HankYu11/3D-printer/docs/04-dfm-and-print-spec.md

# 04 — DFM and Print Specification

## The orientation decision

**Print the part lying on a cheek. Build direction is the part's lateral (Y)
axis.** Everything else in the DFM follows from this, and it is worth the space
because it is the single highest-leverage decision in the design.

### Why not upright

Printed upright — shoe flat on the bed, grip rising — the layer planes are
horizontal. The neck's bending stress and the dovetail wall's splay stress both
run vertically, which means they run **normal to every layer bond**. PETG's
interlayer strength is roughly 27 MPa against about 47 MPa in-plane, so upright
printing throws away ~43 % of the material's strength in exactly the direction
the part is loaded. The grip would also need support under the raked stem.

### Why on a cheek

Lying on a cheek, the layer planes are the part's XZ planes. Now:

- The neck's bending stress lies **inside** the layer plane, carried by
  continuous extrusions rather than by bonds between them.
- The dovetail wall's splay stress likewise runs along Z, in-plane.
- The entire dovetail profile is drawn as an **in-plane contour** — XY precision
  rather than Z-stacked steps. This is the best possible case for a precision
  mating feature.
- The compliant floor leaf flexes in-plane, so it survives thousands of cycles
  instead of snapping along a layer line on the first hard mount.

Quantified, from `analysis.dovetail_wall()` on the governing feature:

| | cheek-down | upright |
|---|---|---|
| Dovetail wall safety factor | **4.42** | 2.54 |

Same geometry, same material, same load. A 1.74× strength difference, free.

### Why it costs nothing

This is the part that makes it an easy decision. Lying a rounded object on its
side is normally a support nightmare: the whole lower half grows outward and
overhangs. **It does not here, because the cheeks are flat.** A flat cheek means
the silhouette barely changes with build height, so the walls stay vertical from
first layer to last.

And the flat cheek was not adopted for printing — it is the correct ergonomic
section (`02`, §1.5) and the customisation canvas (`02`, §1.8). The DFM
constraint, the ergonomics and the branding surface are the same surface.

The result is a **squat** print:

| | |
|---|---|
| Footprint | 81.4 × 100.3 mm |
| Build height | **30.0 mm** |
| Layers at 0.2 mm | **150** |
| Bed contact | full flat cheek, 3 024 mm² measured |
| Support material | **none** |

A 150-layer print cannot topple, has no tall-thin resonance, needs no brim, and
the bed-side cheek comes off a smooth plate with a near-moulded finish.

### The flat cheek has to actually be flat

This was got wrong. The profile table originally varied its lateral scale over
the last three stations — 0.947 to 1.013, which on a 32 mm grip is 1.06 mm of
variation. The cheek was therefore not a plane but a very shallow barrel, and
printed cheek-down only the butt-flare band touched the plate: **117 mm² of bed
contact instead of 3 024 mm²**, with the whole main cheek floating 0.2 mm above
it as a large near-horizontal unsupported face. Measured on the mesh, 22.2 % of
the surface came back as sub-45° down-facing.

It still printed, which is exactly why it survived review — but the bed contact
and the support-free claim were both fiction. The lateral scale is now pinned to
1.0 at every station and asserted at import; the butt flare is shaped in
fore-aft depth instead, which is where it does its job anyway. Flagged area
dropped to 8.6 %, and what is left is not support:

| Remaining sub-45° area | What it is |
|---|---|
| ~1 270 mm² in the first 3 mm | the convex roll-off of the bottom corner radius — self-supporting, no slicer generates support for it; costs a little elephant-foot, which is the price of a filleted edge instead of a chamfered one |
| ~540 mm² at mid-height | the ballast socket roof — a **7.7 mm flat bridge by design** |
| ~19 mm² | the tournament-lock bore roof, a 4.2 mm bridge |

No true unsupported overhang remains. Verify any revision with
`scratchpad/overhang.py`-style mesh checks rather than by assertion.

### What the orientation actually constrains

Worth being precise about, because it is easy to over-credit: printing
cheek-down means the build direction is **lateral**, so anything shaped in the
fore-aft/vertical plane prints as a vertical wall whatever its angle. Finger
scallops, the recoil shelf, the butt flare, the palm swell, the rake, the
texture — none of them is constrained by printability at all. The ergonomics
are free.

Only two things are actually constrained:

1. **Lateral width variation**, because that is the bed face. The cheeks must
   stay coplanar — and they want to be flat anyway, for bed adhesion and
   because they are the branding canvas.
2. **Enclosed void roofs**, which is why the ballast hexagon is oriented
   flats-to-cheeks.

So support-free here is a *property* of a geometry chosen for other reasons,
not a constraint that shaped it. Treat it as a preference rather than a gate:
if a future feature genuinely needs support, that is a trade worth making —
with one exception. The ballast bay is a 46 mm **blind** pocket, and support
inside it cannot be removed. That one stays self-supporting on pain of
scrapping the part.

## Support-free by construction

Every feature was designed against the cheek-down build direction:

| Feature | Why it is self-supporting |
|---|---|
| Dovetail pocket | all faces are vertical walls in this orientation |
| Ballast hex socket | hexagon oriented **flats-to-cheeks** — roof is a flat 7.7 mm bridge approached by 60° walls |
| Finger scallops / knurl | shallow surface cuts, no enclosed overhang |
| Recoil shelf | tapers toward the tip, underside never exceeds 45° |
| Blend collar | converges upward from the shoe footprint |
| Cheek panel + text | 0.8 mm and 0.6 mm pockets in faces normal to build |
| Compliant leaf | in-plane cantilever |

The ballast socket deserves the callout. Rotating that hexagon 30° "to line the
flats up" turns it corner-to-cheek, and the roof stops being a flat bridge — a
blind 46 mm pocket full of support you cannot reach. Both the CadQuery and
OpenSCAD sources carry a comment saying so, because it is exactly the kind of
tidy-looking change a later maintainer makes.

## Material

| | Material | Why | Watch out |
|---|---|---|---|
| **Default** | **PETG** | tough rather than merely strong, snap-load tolerant, low warp, no enclosure, UV-stable | stringing; dry it |
| Premium | ASA / ABS | stiffer, acetone-smoothable, better in a hot car | needs an enclosure; warp |
| Pro | PA6-CF | stiffest, best fatigue life | hardened nozzle; must be dried |
| **Never** | PLA | brittle at the neck, creeps under sustained grip pressure, softens in a car | — |

PLA is excluded on purpose. It would test fine and fail in the field — the load
case is repeated snap loading by a teenager, and a grip that shatters mid-pull
is a safety problem, not a warranty problem.

## Slicer profile (PETG, 0.4 mm nozzle)

| Setting | Value | Reason |
|---|---|---|
| Layer height | 0.2 mm | 150 layers; 0.16 for finer text |
| Perimeters | **4** (1.6 mm) | shell carries the load; the in-plane path |
| Top / bottom | 5 / 5 | cheek faces are visible surfaces |
| Infill | **15 % gyroid** | isotropic; grip is shell-dominated |
| Nozzle temp | **245–255 °C** | run hot — interlayer bonding is the point |
| Bed | 80 °C, smooth PEI | bed-side cheek is a finished surface |
| Cooling | 30–50 % | enough for bridges, not enough to spoil bonding |
| Seam | rear corner, aligned | keep it off the cheek panel |
| Support | **none** | by construction |

Two deviations from a generic profile, both load-bearing:

- **Four perimeters, not three.** The shell is the structure here; infill is
  nearly incidental.
- **Upper-range nozzle temperature.** Interlayer strength is the whole argument
  for the orientation choice; printing cool would give some of it back.

## Stress-concentration discipline

- **No sharp internal corners anywhere in the load path.** Every section carries
  a corner radius that scales with hand size (9.0–10.0 mm).
- Blend collar instead of a fillet at the neck — not a cosmetic choice, see
  `02` §1.2.
- Recoil shelf root filleted R2.5, tapering to R1.6 at the tip.
- Ballast socket leaves **8.3 mm** of cheek wall; `params.validate()` refuses any
  order that would take it below 2.4 mm.

## Envelope compliance

Verified across the full published fit range by `python -m vertex.validate`:

| hand | rake | girth | mass | time | wall SF | status |
|---|---|---|---|---|---|---|
| 80 | 20° | 124.5 mm | 46.4 g | 1.23 h | 4.42 | ok |
| 85 | 19° | 128.6 mm | 49.8 g | 1.32 h | 4.42 | ok |
| 90 | 18° | 132.7 mm | 53.3 g | 1.41 h | 4.42 | ok |
| 95 | 17° | 136.8 mm | 56.9 g | 1.51 h | 4.42 | ok |
| 100 | 16° | 140.8 mm | 60.7 g | 1.61 h | 4.42 | ok |
| 90 | 10° | 132.7 mm | 53.2 g | 1.41 h | 4.42 | ok |
| 90 | 32° | 132.7 mm | 53.4 g | 1.41 h | 4.42 | ok |

Envelope 40–75 g and under 3 h, met with margin at both extremes. The
as-shipped unit with knurl texture is 54.7 g / 1.45 h.

Mass and time are **first-order estimates** — a shell of `shell_thick` over the
measured surface area plus `infill_fraction` inside. Time now comes from the
machine profile rather than one magic throughput figure, because the honest
answer differs by about 3× across machines that all print this same file:

```
line_width = nozzle × 1.05
rate       = min(line_width × layer_height × speed, max_flow) × duty_cycle
```

The default profile is a modern CoreXY — 0.4 mm at 0.2 mm and 200 mm/s, where
the hotend's 11 mm³/s flow ceiling binds rather than the motion system, giving
8.25 mm³/s effective. That is the machine the 3 h envelope was written against.
A slower machine is a preset override: the library-printer profile at 70 mm/s
manages 4.41 mm³/s and takes roughly twice as long for the same file. Quoting a
single number would hide exactly the decision a user on a library printer needs
to make.

They exist to reject an impossible order before it ties up a printer. **The
slicer is authoritative**, and the manifest says so.
