HankYu11/3D-printer/(commit log)

2026-10-26 Add VERTEX-1 parametric launcher grip: proposal, generator, analysis
    An MVP aftermarket grip for the Beyblade X winder launcher, designed as an
    angular repeatability fixture rather than a comfort accessory, plus the
    parametric pipeline that builds one per customer.
    Design proposal (docs/01-06):
    - Three ergonomic archetypes, and why two of them collapse into one
    parametric part once rake and girth are continuous inputs. The modular
    skeleton is deferred: its joints add play to the one thing the product
    exists to remove.
    - Flagship anatomy, dimensional schedule, load path, DFM and the
    order-to-part pipeline.
    Generator (cad/vertex, CadQuery -> STEP/STL + JSON manifest):
    - Builds a sing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
    [vertex_grip.scad]
2026-10-26 Add Qisi Tech Edition; fix non-planar cheeks and hard-coded wall
    Generates cad/vertex/export/grip_qisi_edition.{step,stl,json} plus a
    matching 32 mm fit gauge, and extends the generator with what the brand
    build needed.
    Generator:
    - Per-face branding: player_id_left / player_id_right, independently
    size-fitted and independently drafted.
    - Drafted deboss with AUTO-LIMITING. A draft D on a pocket of depth d
    closes 2*d*tan(D) of inter-glyph gap, so 45 deg on 0.8 mm closes
    1.60 mm. Measured: QISI survives 45 deg, VERTEX-01 merges at 29 deg
    and self-intersects by 37 deg, so it gets 25 deg. The generator counts
    glyph solids and steps the angle down rather than shipping a blob.
    Cut as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
2026-10-26 Record support-free as a property, not a design gate
    Support-free is nice-to-have, not a hard rule, so be precise about what
    it actually bought.
    Printed cheek-down the build direction is lateral, so anything shaped in
    the fore-aft/vertical plane is a vertical wall whatever its angle: the
    finger scallops, recoil shelf, butt flare, palm swell, rake and texture
    are not constrained by printability at all. Only the cheek plane (the bed
    face) and enclosed void roofs are. Relaxing the requirement therefore
    buys no ergonomic freedom back, and nothing in the geometry changes.
    The one place it still binds: the ballast bay is a 46 mm blind pocket and
    support inside it cannot be removed.
    Also correct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
2026-10-26 Lock Qisi production profile; fix perimeter-count error in DFM table
    Decisions confirmed: panel_recess stays 0, geometry ships as exported.
    Corrects a real error in the previous DFM table. It labelled rows by
    perimeter COUNT while computing from shell thickness in mm, and those are
    not the same thing across nozzle sizes: a perimeter is a nozzle-width
    wide, so 3 perimeters is 1.26 mm on a 0.4 mm nozzle but 1.89 mm on a
    0.6 mm one. The recommended "0.6 mm, 3 perimeters, 15% -> 50.8 g / 83 min"
    would in fact have printed at 66.2 g / 108 min.
    The intended operating point is 1.26 mm of shell, which on a 0.6 mm
    nozzle is 2 perimeters, not 3 -- the same wall as 3 perimeters at 0.4 mm,
    laid down i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
2026-10-27 Make the fit gauge actually quick to print
    Reported as a 4 h print in Cura. It was: 2.5-4 h depending on profile.
    docs/03 and the module docstring both claimed "roughly 10-15 minutes",
    which was never computed -- the claim survived precisely because it was
    asserted rather than measured.
    Root cause: the gauge repeated the full production shoe five times, so
    the coupon carried MORE surface area than the grip itself (23 905 vs
    21 167 mm2), and the leaf spring's relief slot was the one feature on
    this project that forces support.
    Stripped to what it measures:
    - floor cut from 4.8 mm to 1.6 mm (it only has to hold the dovetail)
    - no leaf spring; preload is not what this measures and it is valid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
2026-10-27 Calibrate print-time model against a measured Cura slice
    Cura reported 8.32 m of 1.75 mm filament in 2 h 47 m for the 5-station
    gauge: 20 012 mm3 in 167 min = 2.00 mm3/s, against a nominal
    0.42 x 0.2 x 50 = 4.20 mm3/s. Real duty is 0.48, not the 0.75 the model
    assumed, so every time estimate in this project was optimistic by ~1.6x.
    The gap is mostly Cura running the OUTER WALL at half the print speed
    (25 mm/s default), with top/bottom at 25 and initial layer at 20. These
    parts are shell-dominated, so most of the time is spent in exactly those
    moves. duty_cycle default is now 0.50, documented with the measurement
    that produced it, and rail_gauge no longer hard-codes its own copy.
    The librar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
2026-10-27 Add single-station gauge mode with a caliper reference
    --stations 1 now prints the clearance the grip is actually built with
    (FIT_CLEARANCE_DEFAULT) rather than an arbitrary middle rung: if it fits,
    there is nothing left to calibrate and the grip can follow directly.
    --clearance C prints one station at any value.
    A single station has no ladder to compare against, so the run also prints
    the nominal pocket dimensions. Calipers on the printed pocket then
    separate the two unknowns this part sits between -- how far the printer
    missed the model, and how far the model misses the real launcher. Without
    that split a part that does not fit tells you nothing about which of the
    two is wrong, and only t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
2026-10-27 Document the assumed launcher interface with a fit diagram
    Adds docs/images/gauge-fit.png and references it from docs/03: an
    exploded section of the assumed dovetail against the printed gauge, with
    the six dimensions to check with calipers.
    Both halves are generated from RAIL_NOMINAL, so the diagram states a
    question rather than an answer -- does the launcher actually carry a rail
    wider at its tip than at its base? If the real mount is pegs, a tab or a
    clip, the gauge reports nothing useful and no clearance value helps. That
    distinction is the one the coupon exists to make, and it is cheaper to
    make it by eye before test-fitting.
    Claude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
2026-10-27 Record that the dovetail is wrong in kind, not just unmeasured
    Photos of the official Beyblade X grip accessory show a block marked
    "LOCK" at the head of the handle, and the demo caption tells the user to
    push harder to seat it. That is a snap/clamp engagement.
    RAIL_NOMINAL models a slide-on dovetail: the launcher enters endwise and
    wedges on a 1.2 deg taper. These are different mechanisms, and no
    clearance value converts one into the other -- so this is not the
    tolerance problem the calibration gauge was built to solve.
    Noted at the top of interface.py and docs/03 so nobody later mistakes
    RAIL_NOMINAL for a starting point to refine. Expect build_shoe() to be
    replaced outright, not adjuste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
